Sevval-Karakurt/Adaptive-Noise-Analysis-and-Smart-Work-Environment-System/README.md

# Adaptive-Noise-Analysis-and-Smart-Work-Environment-System
Real-time noise analysis and smart workspace monitoring system featuring MSP430, MAX9814, and HC-05 Bluetooth.
