Sevval-Karakurt/Adaptive-Noise-Analysis-and-Smart-Work-Environment-System/Çıktı 1.pdf

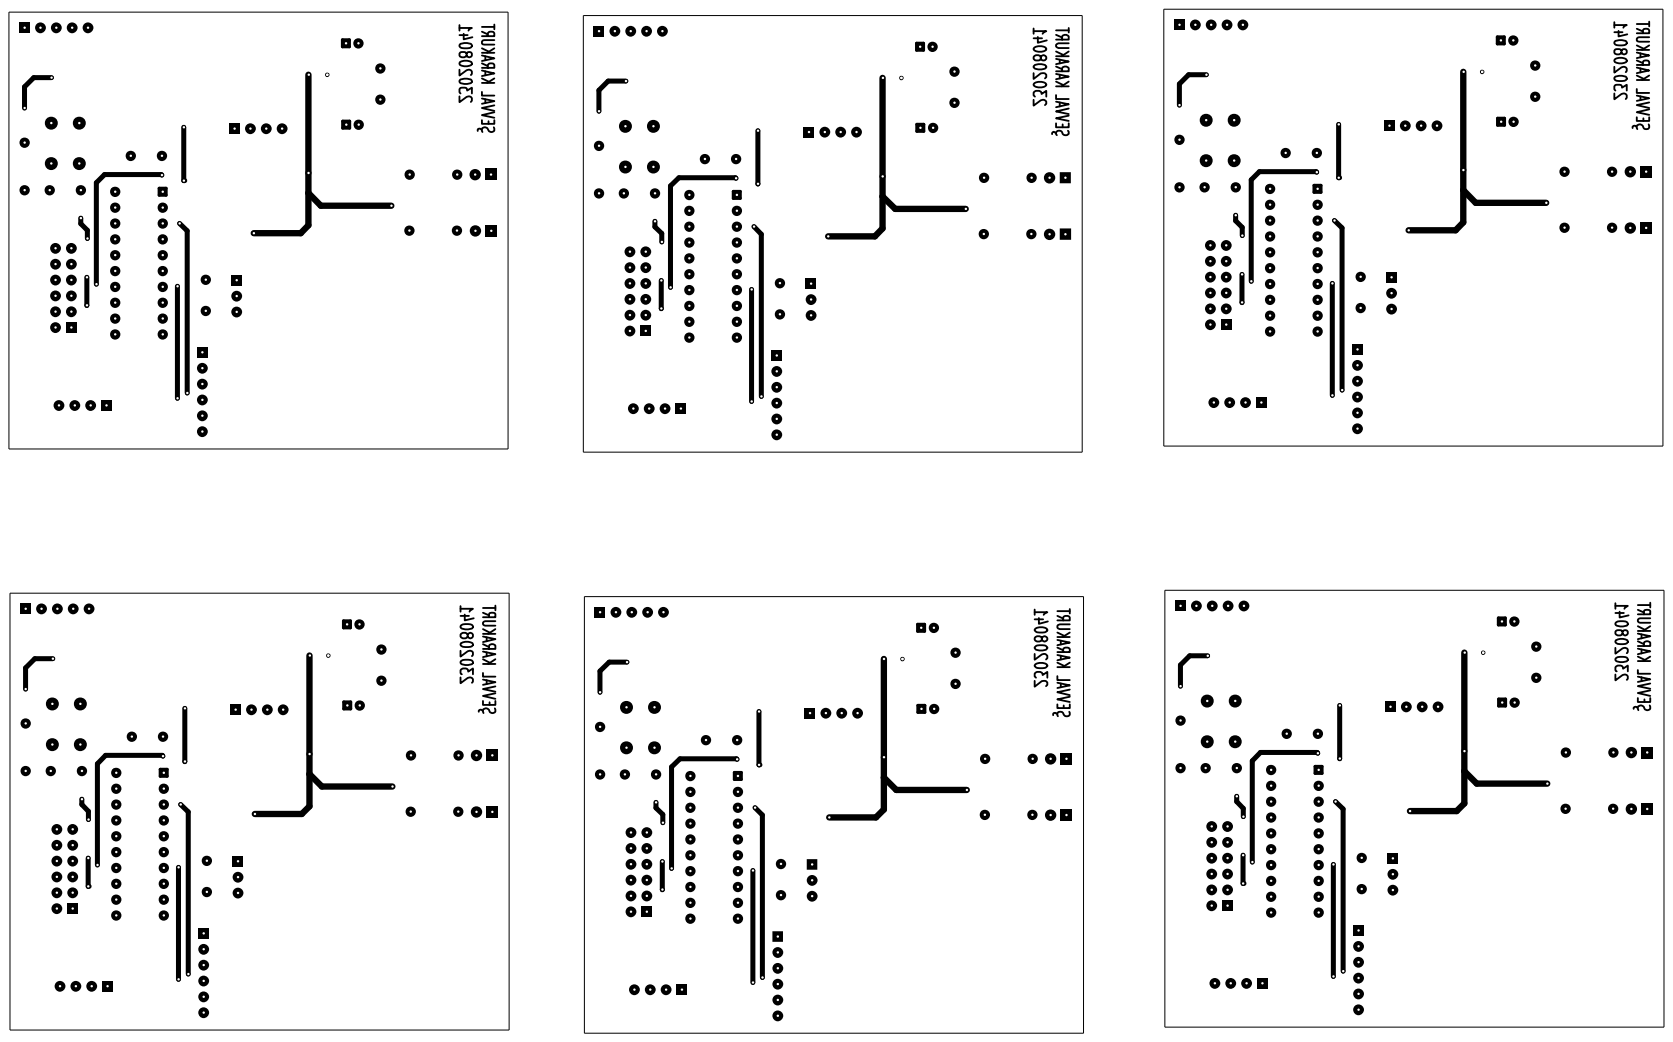
[picture p26: page 1]
