Sevval-Karakurt/Adaptive-Noise-Analysis-and-Smart-Work-Environment-System/Çıktı 2.pdf

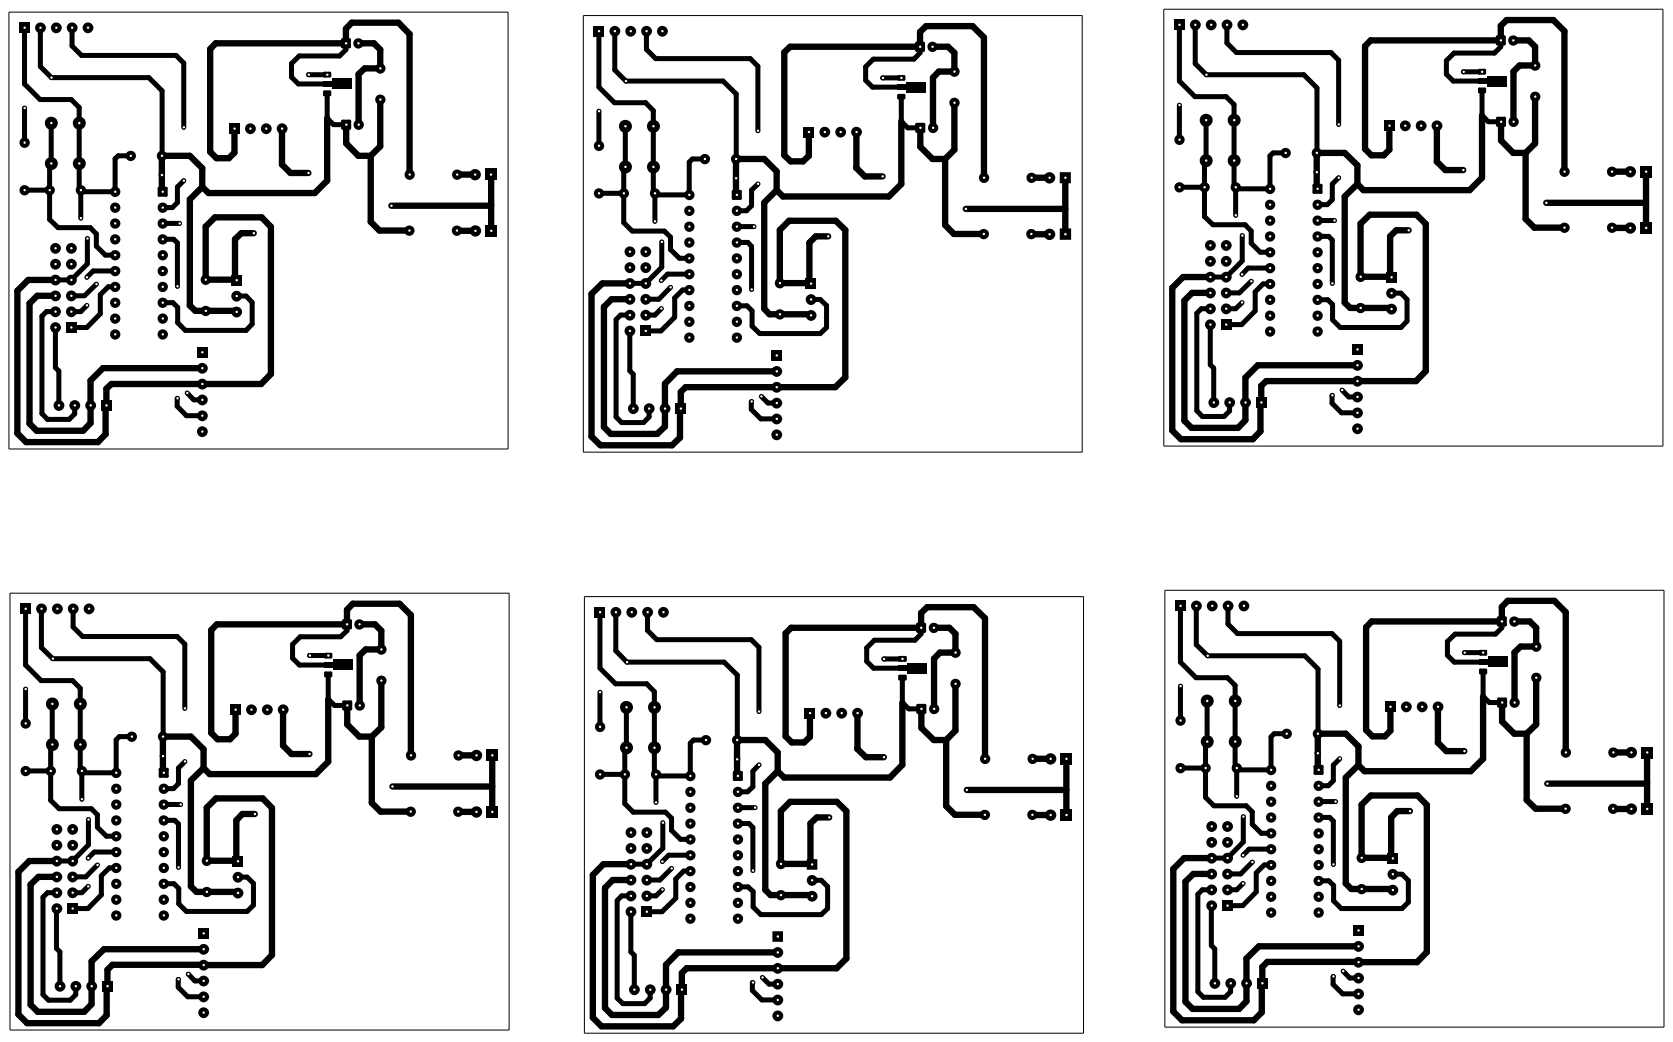
[picture p27: page 1]
