Sevval-Karakurt/Adaptive-Noise-Analysis-and-Smart-Work-Environment-System/Mikro şevval.kicad_pcb

## KiCad design Mikro şevval.kicad_pcb (2026-09-23)

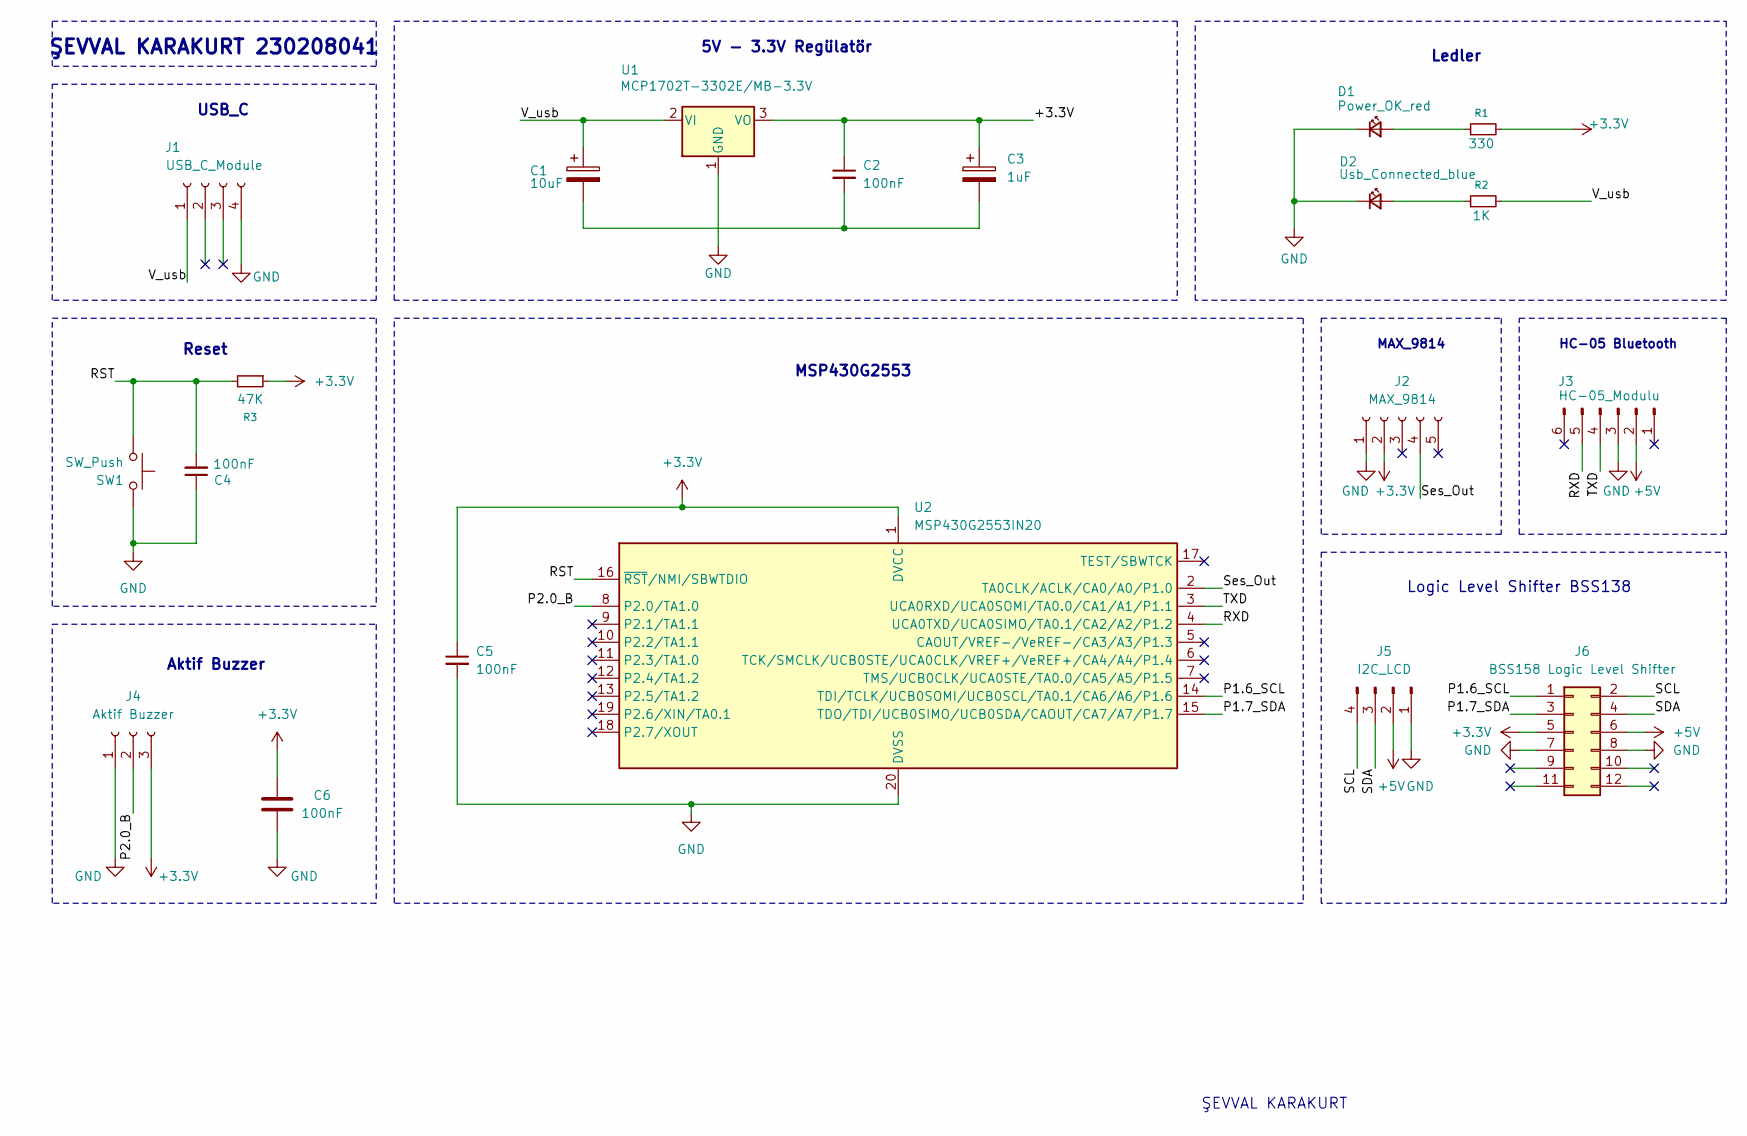
[picture p28: schematic Mikro şevval.kicad_sch]

Parts:
C1: 10uF; CP_Radial_D5.0mm_P2.00mm
C2, C4, C5, C6: 100nF; C_Rect_L7.2mm_W2.5mm_P5.00mm_FKS2_FKP2_MKS2_MKP2
C3: 1uF; CP_Radial_D5.0mm_P2.00mm
D1: Power_OK_red; LED_D3.0mm
D2: Usb_Connected_blue; LED_D3.0mm
J1: USB_C_Module; PinSocket_1x04_P2.54mm_Vertical
J2: MAX_9814; PinSocket_1x05_P2.54mm_Vertical
J3: HC-05_Modulu; PinSocket_1x06_P2.54mm_Vertical
J4: Aktif Buzzer; PinSocket_1x03_P2.54mm_Vertical
J5: I2C_LCD; PinSocket_1x04_P2.54mm_Vertical
J6: BSS158 Logic Level Shifter; PinSocket_2x06_P2.54mm_Vertical
R1: 330; R_Axial_DIN0207_L6.3mm_D2.5mm_P7.62mm_Horizontal
R2: 1K; R_Axial_DIN0207_L6.3mm_D2.5mm_P7.62mm_Horizontal
R3: 47K; R_Axial_DIN0207_L6.3mm_D2.5mm_P7.62mm_Horizontal
SW1: SW_Push; SW_PUSH_6mm
U1: MCP1702T-3302E/MB-3.3V; SOT-89-3
U2: MSP430G2553IN20; DIP-20_W7.62mm

Connections:
+3.3V: C2.1, C3.1, C5.1, C6.2, J2.2, J4.3, J6.5, R1.2, R3.1, U1.3 (VO), U2.1 (DVCC)
+5V: J3.2, J5.2, J6.6
/P1.6_SCL: J6.1, U2.14 (TDI/TCLK/UCB0SOMI/UCB0SCL/TA0.1/CA6/A6/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)
/P1.7_SDA: J6.3, U2.15 (TDO/TDI/UCB0SIMO/UCB0SDA/CAOUT/CA7/A7/P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)
/P2.0_B: J4.2, U2.8 (P2.0/TA1.0)
/RST: C4.2, R3.2, SW1.1, U2.16 (~RST/NMI/SBWTDIO)
/RXD: J3.5, U2.4 (UCA0TXD/UCA0SIMO/TA0.1/CA2/A2/P1.2)
/SCL: J5.4, J6.2
/SDA: J5.3, J6.4
/Ses_Out: J2.4, U2.2 (TA0CLK/ACLK/CA0/A0/P1.0)
/TXD: J3.4, U2.3 (UCA0RXD/UCA0SOMI/TA0.0/CA1/A1/P1.1)
/V_usb: C1.1, J1.1, R2.2, U1.2 (VI)
GND: C4.1, C5.2, C6.1, D1.1 (K), D2.1 (K), J1.4, J2.1, J3.3, J4.1, J5.1, J6.7, J6.8, SW1.2, U1.1 (GND), U2.20 (DVSS)
unnamed: C1.2, C2.2, C3.2
unnamed: D1.2 (A), R1.1
unnamed: D2.2 (A), R2.1

Notes on the sheet:
HC-05 Bluetooth
5V - 3.3V Regülatör
Logic Level Shifter BSS138
Aktif Buzzer
ŞEVVAL KARAKURT 230208041
Ledler
MSP430G2553
Reset
MAX_9814
ŞEVVAL KARAKURT
USB_C

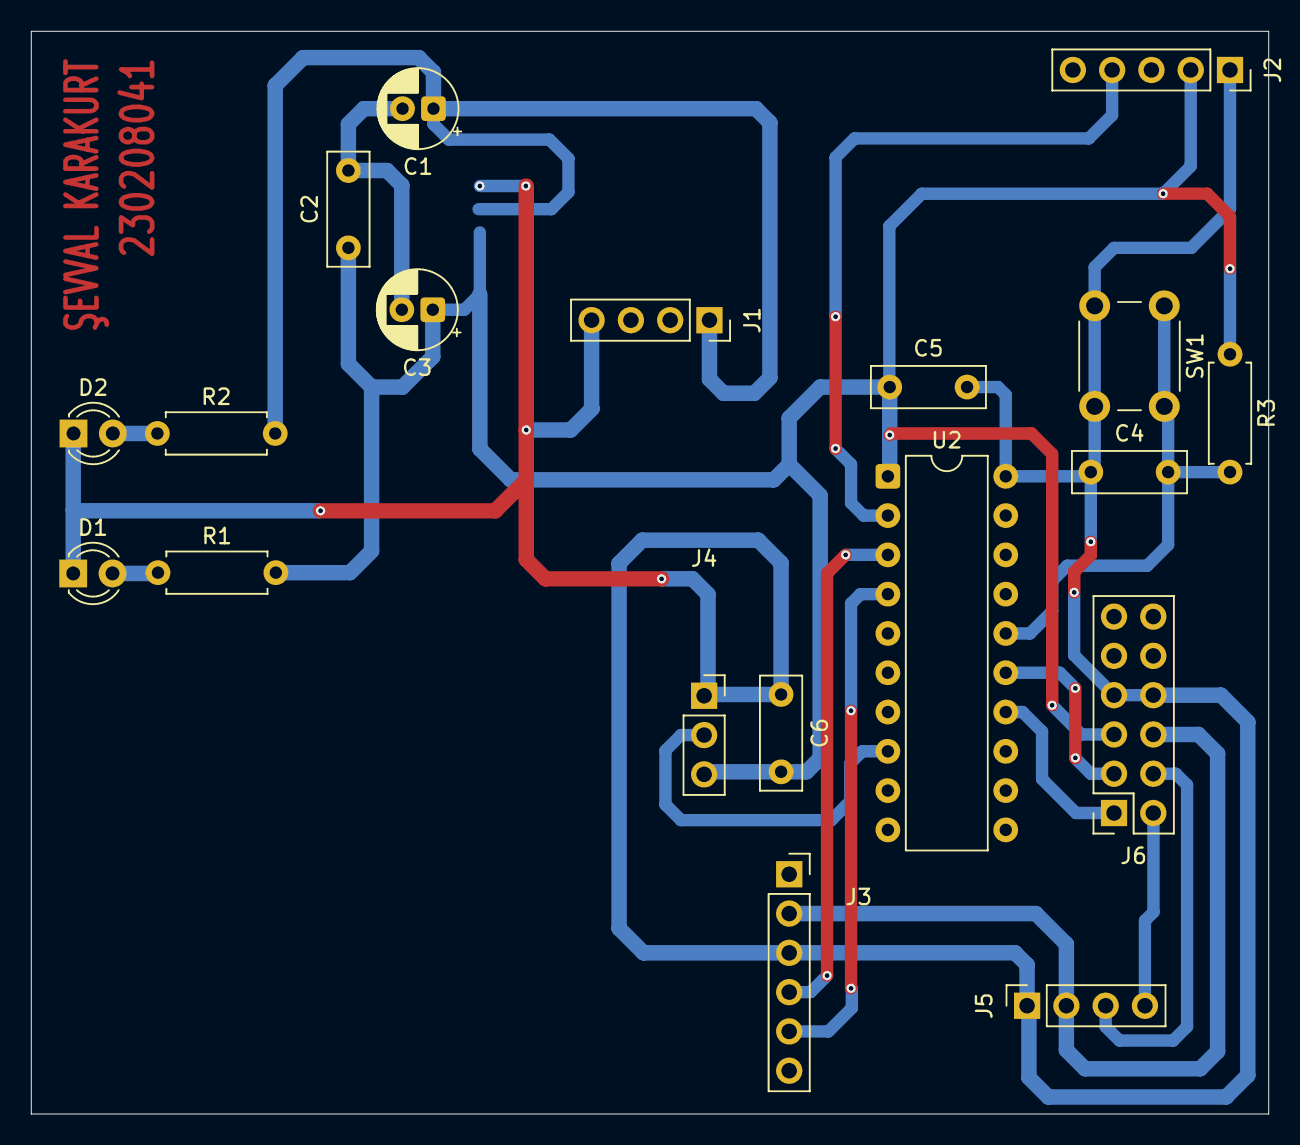
[picture p29: board Mikro şevval.kicad_pcb from above]

Board: 2 copper layers, 80.0 x 70.0 mm, 20 parts (1 on the bottom side), 16 nets.
